akielaries/m1core/README.md

ARM Cortex M1 softcore implementation. Takes up lots of resources right now with no features.
