akielaries/m1core/docs/soc-config.md

# SoC configuration and generation

How m1core gets configured: which peripherals exist, where they live, and which
interrupt each one owns. This is the scaffolding that makes peripherals cheap to
add and makes a configurator GUI a thin layer rather than a rewrite.

## The core argument: generate, don't parameterise

There are two ways to make a SoC configurable.

**Parameterise.** One `m1core_soc.v` with `HAS_UART`, `HAS_SPI`, `NUM_GPIO`
parameters and `generate` blocks around every instance. This is where these
projects usually end up, and it rots: the fabric decode becomes a nest of
conditionals, the address map is implicit in the RTL, adding a peripheral edits
five files, and the C header drifts from the hardware.

**Generate.** Describe the SoC as data, and emit the RTL. Gowin's own IP
configurator works this way, which is the tell: it does not ship one mega-module
with a hundred parameters, it writes you a wrapper.

m1core generates. The consequences are worth being explicit about:

- The address map lives in **one** place and the RTL, the C header and the docs
  are all derived from it, so they cannot disagree.
- Adding a peripheral is a few lines of config plus a self-contained block.
- The generated top is plain readable Verilog you can diff, check in, and hand to
  someone with no generator installed.
- A GUI becomes a form that writes YAML. That is a weekend. Building the GUI
  first, before the config format exists, means hardcoding assumptions into it
  and then rewriting it.

**So: config schema and CLI generator first, GUI last.** The GUI is the cheap
part once the data model is right, and the expensive part if it is not.

## Two layers, two tools

There is a clean split, and conflating the two is what makes these systems
unpleasant:

| Layer | Question it answers | Tool |
| --- | --- | --- |
| Registers *within* a peripheral | what bits does UART0's CTRL have | Cheby |
| Composition *of* the SoC | is there a UART0, at what base, on which IRQ | m1core generator |

Cheby is already in use for the ACM register maps and emits both an RTL register
block and a C header from one YAML. That is exactly the right tool for the inner
layer, and reusing it means peripheral authors have one familiar workflow.

The outer layer is much simpler: a list of instances with a base address, an IRQ
number, and a handful of options.

## Bus structure

```
                 +-------------+
   m1core_cpu ---|             |--- ITCM      (AHB, zero wait state)
                 |  AHB fabric |--- DTCM      (AHB, zero wait state)
   MEM-AP     ---|             |--- PPB       (AHB, scs/rom table)
                 +-------------+--- AHB2APB --+-- UART0   (APB)
                                              +-- SPI0    (APB)
                                              +-- I2C0    (APB)
                                              +-- GPIO0   (APB)
```

Memory and the debug PPB stay on AHB, where zero wait states matter. Everything
else goes behind an AHB-to-APB bridge. Three reasons:

1. **Timing.** Every AHB slave widens the fabric decode and the read mux, and
   that mux already feeds the path nearest the timing limit. Peripherals behind a
   bridge cost the AHB fabric exactly one slot no matter how many there are.
2. **Peripherals get simpler.** APB has no pipelined address/data phase. A
   peripheral is a register file with a strobe. That matters when the point is
   for other people to drop blocks in.
3. **It is the conventional Cortex-M structure**, so it matches what anyone
   coming from an STM32 or a Gowin eMPU expects, and it matches the
   `apb_ahb_bridge.v` already in the AFM project.

## Interrupt numbering

The IRQ map deliberately follows Gowin's eMPU M1 where the peripherals
correspond:

| IRQ | Source |
| --- | --- |
| 0 | UART0 |
| 1 | UART1 |
| 2 | TIMER0 |
| 3 | TIMER1 |
| 4 | GPIO0 |
| 6 | RTC |
| 7 | I2C |

Same reasoning as the CoreSight ID contract: matching an existing convention
costs nothing and buys compatibility. m1kern already targets these numbers, so
its target layer ports with almost no change.

Unused IRQ lines tie low. The NVIC is sized to the highest number in use.

## Config format

One file describes an SoC instance:

```yaml
soc:
  name: m1core_tang25k
  cpu:
    itcm_kb: 16
    dtcm_kb: 8
  peripherals:
    - { type: uart, name: uart0, base: 0x40000000, irq: 0, baud: 115200 }
    - { type: gpio, name: gpio0, base: 0x40001000, irq: 4, width: 8 }
    - { type: spi,  name: spi0,  base: 0x40002000 }
```

From that, the generator emits:

- `m1core_soc_gen.v` — the APB decoder, peripheral instances, IRQ vector
- `m1core_soc.h` — base addresses, IRQ enum, matching the CMSIS layout m1kern
  expects
- `memory-map.md` — the same information for humans

Peripheral register definitions stay in Cheby YAML per block, so the generator
never needs to know what is inside a UART.

## How the generator gets built safely

The first job of the generator is not to enable a new peripheral. It is to
**reproduce the SoC that already exists**, byte for byte where practical:

1. `boards/gw5a25/soc.yaml` describes the current design, nothing more.
2. The generator emits the C device header from it. Diff against the
   hand-written `sw/baremetal/bsp/m1core.h`. They must agree.
3. Then `docs/memory-map.md`, same check.
4. Then the RTL: the APB decode and peripheral instantiation currently written
   by hand in `m1core_soc.v`. Diff against what is there now, and the whole
   regression must still pass against generated RTL.
5. Only then add a peripheral that does not exist yet.

**Steps 1 to 4 are done.** `tools/m1core_gen.py` emits the C device header, the
generated section of `docs/memory-map.md`, and `rtl/soc/m1core_apb.v`. All three
are checked by `make checkgen`, which runs as part of the regression, so a hand
edit to any of them fails locally.

## What is generated, and what is not

Adding an APB peripheral is four lines of `soc.yaml`. Regenerating produces its
address decode, its slot in the read data and ready mux, its entry in the
interrupt vector, its instantiation, its base address and IRQ number in the C
header, and its row in the memory map. Verified by adding a second UART and
reading the diff.

What it does **not** yet do is route that peripheral's external pins up through
`m1core_soc.v` and the board top. The generated module grows the ports; wiring
them to a physical pin is still a manual edit in two files, and iverilog reports
them as dangling until you do:

```
warning: Instantiating module m1core_apb with dangling input port uart1_rxd
```

That is the honest boundary today. Closing it means generating `m1core_soc.v`
itself, which is the natural next step and is a bigger change: that file also
contains the CPU, the debug access port, the fabric and the memories, none of
which vary with the peripheral list.

Reproducing something known-good is a checkable milestone. Generating something
new is not — if the output is wrong you cannot tell whether the generator or the
new block is at fault.

## Order of work

1. **AHB-to-APB bridge**, and a written peripheral contract. Structural, and
   everything else assumes it.
2. **UART on APB.** The first real peripheral, and the thing that proves the
   contract end to end. Also the most immediately useful: printf beats an LED.
3. **Generator**, once there are two peripherals to compose and the shape of the
   problem is known from real examples rather than guessed at. *Done for the C
   header:* `tools/m1core_gen.py` emits `sw/baremetal/bsp/m1core.h` from
   `boards/gw5a25/soc.yaml` plus the per-type layouts in `tools/peripherals/`.
   `make checkgen` fails the regression if the two ever disagree.
4. **Exceptions and NVIC.** The gate to m1kern and to interrupts being useful.
5. **More peripherals**, which by then are cheap.
6. **GUI**, a form over the YAML.

## GUI technology

Python with Qt (PySide6), when the time comes.

The generator is Python, so the GUI can import it directly rather than shelling
out and parsing text, and there is one language to maintain. It matches the
tooling already in use here — Cheby, the SI suite, `tools/*.py` — and Gowin's own
IDE is Qt, so it will not feel foreign next to it.

The rule that keeps it cheap: **the GUI never contains logic.** It edits YAML and
calls the generator. Every validation rule (overlapping address ranges, duplicate
IRQ numbers, a peripheral on a bus that does not exist) belongs in the generator
where the CLI gets it too, and where it can be tested without clicking anything.
A GUI that knows things the CLI does not is how these tools rot.

Steps 1 and 2 before the generator is deliberate: writing a generator against one
hypothetical peripheral produces the wrong abstraction. Two real ones is enough
to see the pattern and not so many that the rework hurts.
