akielaries/m1core/boards/mega60k/src/gowin_pll/gowin_pll_tmp.v

//Copyright (C)2014-2025 Gowin Semiconductor Corporation.
//All rights reserved.
//File Title: Template file for instantiation
//Part Number: GW5AT-LV60PG484AC2/I1
//Device: GW5AT-60
//Device Version: B


//Change the instance name and port connections to the signal names
//--------Copy here to design--------
    Gowin_PLL your_instance_name(
        .clkin(clkin), //input  clkin
        .clkout0(clkout0), //output  clkout0
        .lock(lock), //output  lock
        .mdclk(mdclk) //input  mdclk
);


//--------Copy end-------------------
