akielaries/m1core/(commit log)

2026-08-17 88mhz for the core
    [device.cfg]
2026-08-18 running at 50mhz from on board xtal
    [device.cfg]
